DEv-vUltra/Mobile-controller-/Design reference/TPS56A37/Screenshot 2026-10-19 120438.png

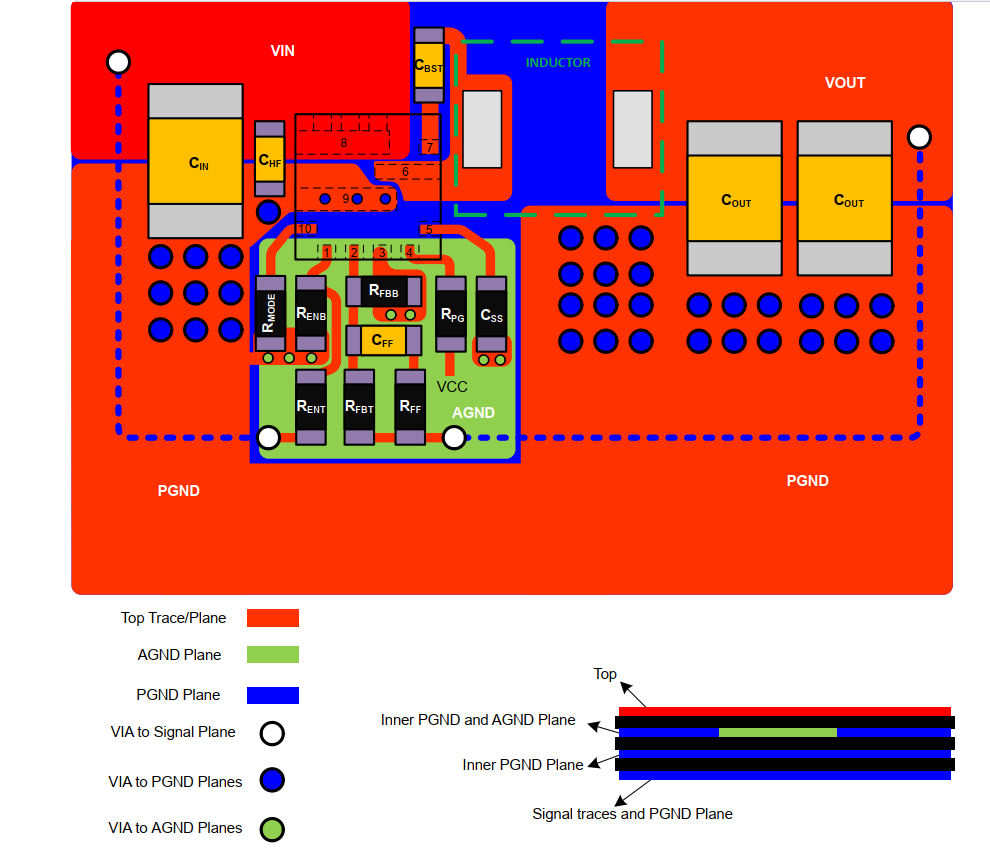
Design reference/TPS56A37/Screenshot 2026-10-19 120438.png
