DEv-vUltra/Mobile-controller-/Manufacture folders/BOM/Mobile_controller_BOM.csv

Id | Designator | Footprint | Quantity | Designation | Manufacturer | Manufacturer Part Number | LCSC Part#
1 | C1, C2, C4, C5, C9, C12, C33, C37, C38, C45, C48, C50, C58 | C_0603_1608Metric_Pad1.08x0.95mm_HandSolder | 13 | 105 | Kyocera AVX | 0603YC105JAT2A | C2177011
2 | C3, C6, C10, C13, C29, C30, C34, C35, C36, C39, C42, C46, C47, C51, C52, C53, C54, C55, C56, C59, C63, C64, C65, Cboot1 | C_0603_1608Metric_Pad1.08x0.95mm_HandSolder | 24 | 104 | Taiyo Yuden | EMK107B7104KA-T | C3868378
3 | C31, C32 | CP_Elec_6.3x5.4 | 2 | 47uF | FOSAN | FVH035ADA470M0654 | C7469958
4 | C40, C41 | C_0805_2012Metric_Pad1.18x1.45mm_HandSolder | 2 | 35pF | YAGEO | CC0805JRNPO9BN330 | C107115
5 | C43, C44 | C_0603_1608Metric_Pad1.08x0.95mm_HandSolder | 2 | 2.2uF | Samsung Electro-Mechanics | CL10A225KO8NNNC | C23630
6 | C49 | C_0603_1608Metric_Pad1.08x0.95mm_HandSolder | 1 | 4.7uF | muRata | GRM188Z71C475KE21D | C389010
7 | C60 | C_0603_1608Metric_Pad1.08x0.95mm_HandSolder | 1 | 47nF | YAGEO | CC0603JRX7R7BB473 | C519536
8 | C61, C62 | C_0603_1608Metric_Pad1.08x0.95mm_HandSolder | 2 | 100pF | YAGEO | CC0603FRNPO9BN101 | C513648
9 | Cboot2 | C_0603_1608Metric_Pad1.08x0.95mm_HandSolder | 1 | 0.01uF | YAGEO | CC0603KRX7R9BB103 | C100042
10 | Cb_inpflt1 | CP_Elec_10x10 | 1 | 33uF | Panasonic | EEHZA1K330P | C128469
11 | Cff1 | C_0603_1608Metric_Pad1.08x0.95mm_HandSolder | 1 | 30pF | FH (Guangdong Fenghua Advanced Tech) | 0603CG300F500NT | C501847
12 | Cf_inpflt1, Cf_inpflt2 | CP_Elec_6.3x5.9 | 2 | 22uF | Panasonic | 35SVPF22M | C88142
13 | Cin1, Cin2 | C_1210_3225Metric_Pad1.33x2.70mm_HandSolder | 2 | 10uF | Taiyo Yuden | MSASU32MSB5106KPNA01 | C5677734
14 | Cin3, Cin4 | C_0805_2012Metric_Pad1.18x1.45mm_HandSolder | 2 | 4.7uF | MuRata | GRM31CR71H475KA12L | C77096
15 | Cinx1 | C_0805_2012Metric_Pad1.18x1.45mm_HandSolder | 1 | 104 | Yageo | CC0805KRX7R9BB104 | C49678
16 | Cout1 | C_1210_3225Metric_Pad1.33x2.70mm_HandSolder | 1 | 22uF | Murata Electronics | GRM32ER61E226KE15L | C65428
17 | Cout3 | CP_EIA-7343-30_AVX-N_HandSolder | 1 | 330uF | Panasonic | 6TPE330MIL | C134173
18 | Css1 | C_0402_1005Metric_Pad0.74x0.62mm_HandSolder | 1 | 104 | MuRata | GRM155R71C223KA01D | C77010
19 | D1 | D_SOD-123 | 1 | 1N4148W | ST(Semtech) | 1N4148W | C81598
20 | D2, D5 | D_SMA | 2 | SS14 SMA | HUXN | SS14(SMA) | C49861244
21 | D3 | LED_0603_1608Metric_Pad1.05x0.95mm_HandSolder | 1 | LED | TONYU | DY-S160806SUWD-100K-T5-4T-03 | C6276853
22 | D4 | DIOM7959X250N | 1 | B540C-13-F | Diodes Inc. | B540C-13-F | C72264
23 | D15 | SOT-23 | 1 | NUP2105L | onsemi | NUP2105LT1G | C14486
24 | F1 | FUSC2012X55N | 1 | MFU0805FF01250P100 | VISHAY | MFU0805FF01250P100 | C1972492
25 | F2 | 01000066Z | 1 | 01000066Z | Littelfuse | 01000066Z | C3204057
26 | FB1 | L_0805_2012Metric_Pad1.05x1.20mm_HandSolder | 1 | CBG201209U601T | FH | CBG201209U601T | C124100
27 | FB2 | L_0805_2012Metric_Pad1.05x1.20mm_HandSolder | 1 | CBW201209U101T | FH | CBW201209U101T | C74487
28 | IC2 | TPS56A37RPAR | 1 | TPS56A37RPAR | TI | TPS56A37RPAR | C22392669
29 | J1 | AMASS_XT60-M_1x02_P7.20mm_Vertical | 1 | Power | Changzhou Amass Elec | XT60-M. | C98733
30 | J2 | JST_PH_S6B-PH-SM4-TB_1x06-1MP_P2.00mm_Horizontal | 1 | MOTOR_LEFT | JST | S6B-PH-SM4-TB(LF)(SN) | C265405
31 | J3 | JST_PH_S6B-PH-SM4-TB_1x06-1MP_P2.00mm_Horizontal | 1 | MOTOR_RIGHT | JST | S6B-PH-SM4-TB(LF)(SN) | C265405
32 | J4 | JST_PH_S4B-PH-SM4-TB_1x04-1MP_P2.00mm_Horizontal | 1 | SW Debug | JST | S4B-PH-SM4-TB(LF)(SN) | C265102
33 | J5 | JST_PH_S4B-PH-SM4-TB_1x04-1MP_P2.00mm_Horizontal | 1 | Telemetry 1 | JST | S4B-PH-SM4-TB(LF)(SN) | C265102
34 | J6 | USB_C_Receptacle_GCT_USB4110 | 1 | USB_C_2.0 | Global Connector Technology | USB4110-GF-A | C5143397
35 | J7 | JST_PH_S3B-PH-SM4-TB_1x03-1MP_P2.00mm_Horizontal | 1 | CAN BUS | JST | S3B-PH-SM4-TB(LF)(SN) | C265101
36 | J8 | PinHeader_1x03_P2.54mm_Vertical | 1 | BOOT_MODE | BOOMELE(Boom Precision Elec) | 2.54-1*3P | C49257
37 | J9 | JST_PH_S4B-PH-SM4-TB_1x04-1MP_P2.00mm_Horizontal | 1 | RC Control | JST | S4B-PH-SM4-TB(LF)(SN) | C265102
38 | J10 | PinHeader_1x03_P2.54mm_Horizontal | 1 | RC Servo | BOOMELE(Boom Precision Elec) | 2.54-1*3P | C92159
39 | L1 | L_12x12mm_H8mm | 1 | 22uH_6.3A | Vishay-Dale | IHLP4040DZER220M11 | C845072
40 | L2 | SRN80408R2Y | 1 | SRN8040-2R2Y | Coilcraft | XAL6060-562MEB | C7419740
41 | L4 | L_Coilcraft_XAL6060-XXX | 1 | 5.6uH | Bourns | SRN8040-2R2Y | C711710
42 | R1, R13, R14, R15, R17 | R_0603_1608Metric_Pad0.98x0.95mm_HandSolder | 5 | 4.7k | YAGEO | RC0603FR-074K7L | C99782
43 | R2 | R_1206_3216Metric_Pad1.30x1.75mm_HandSolder | 1 | 562 | RALEC | RTT065620FTP | C246596
44 | R10, R11 | R_1206_3216Metric_Pad1.30x1.75mm_HandSolder | 2 | 0.2 | PANASONIC | ERJ8CWFR020V | C713435
45 | R12, R16, R18, R19, R22, Rfbt2 | R_0603_1608Metric_Pad0.98x0.95mm_HandSolder | 6 | 10k | UNI-ROYAL(Uniroyal Elec) | 0603WAF1002T5E | C25804
46 | R20, R21 | R_0805_2012Metric_Pad1.20x1.40mm_HandSolder | 2 | 5.1k | YAGEO | RT0805FRE075K1L | C869519
47 | R23, R24 | R_0402_1005Metric_Pad0.72x0.64mm_HandSolder | 2 | 62 | UNI-ROYAL(Uniroyal Elec) | 0402WGF620JTCE | C4962
48 | Rd_inpflt1 | R_0603_1608Metric | 1 | 0.1 | Panasonic | ERJ-3RSFR10V | C713431
49 | Rfbb1 | R_0402_1005Metric_Pad0.72x0.64mm_HandSolder | 1 | 20k | Vishay-Dale | CRCW040220K0FKED | C482096
50 | Rfbb2 | R_0603_1608Metric_Pad0.98x0.95mm_HandSolder | 1 | 3.3k | Vishay-Dale | CRCW06033K24FKEA | C844165
51 | Rfbt1 | R_0805_2012Metric_Pad1.20x1.40mm_HandSolder | 1 | 383k | Panasonic | ERJ-6ENF3833V | C3025630
52 | Rmode1 | R_0402_1005Metric_Pad0.72x0.64mm_HandSolder | 1 | 52.3k | Vishay-Dale | CRCW040252K3FKED | C843906
53 | Rpg1 | R_0402_1005Metric_Pad0.72x0.64mm_HandSolder | 1 | 100k | Vishay-Dale | CRCW0402100KFKED | C481918
54 | SW2 | SW_SPST_TS-1088-xR025 | 1 | RESET | XUNPU | TS-1088R-02026 | C455280
55 | U1 | SOT-23-5 | 1 | AP2112K-3.3 | TECH PUBLIC | AP2112K-3.3TRG1 | C23380830
56 | U2 | SOT-223-3_TabPin2 | 1 | AMS1117-3.3 | Advanced Monolithic Systems | AMS1117-3.3 | C6186
57 | U3 | TI_SO-PowerPAD-8_ThermalVias | 1 | TPS5430DDA | TI | TPS5430DDAR | C9864
58 | U4 | SOT-223-3_TabPin2 | 1 | AMS1117-1.8 | JSMSEMI | AMS1117-1.8 | C963404
59 | U6 | VSSOP-8_2.3x2mm_P0.5mm | 1 | TXS0102DCU | TI | TXS0102DCUR | C53434
60 | U7, U8 | Texas_HTSOP-8-1EP_3.9x4.9mm_P1.27mm_EP2.95x4.9mm_Mask2.4x3.1mm_ThermalVias | 2 | DRV8870DDA | TI | DRV8870DDAR | C86590
61 | U9 | Bosch_LGA-8_2x2.5mm_P0.65mm_ClockwisePinNumbering | 1 | BMP280 | Bosch | BMP280 | C83291
62 | U10 | Quectel_L80-R | 1 | L80-R | Quectel | L80RE-M37 | C3029061
63 | U11 | InvenSense_QFN-24_3x3mm_P0.4mm | 1 | ICM-20948 | TDK InvenSense | ICM-20948 | C726001
64 | U12 | LQFP-64_10x10mm_P0.5mm | 1 | STM32F405RGTx | ST | STM32F405RGT7 | C1337199
65 | U13 | SOT-23-6 | 1 | SN74LVC1T45DBV | TI | SN74LVC1T45DBVR | C7843
66 | U14 | SOT-23-6 | 1 | USBLC6-2SC6 | UMW | USBLC6-2SC6 | C2687116
67 | U15 | SOIC-8_3.9x4.9mm_P1.27mm | 1 | SN65HVD230 | TI | SN65HVD230DR | C12084
68 | Y1 | Crystal_SMD_5032-4Pin_5.0x3.2mm | 1 | 8MHz | YXC Crystal Oscillators | X50328MSB4SI | C157341
