DEv-vUltra/Mobile-controller-/Manufacture folders/Schematic and Assembly PDF/Mobile_controller_assembly.pdf

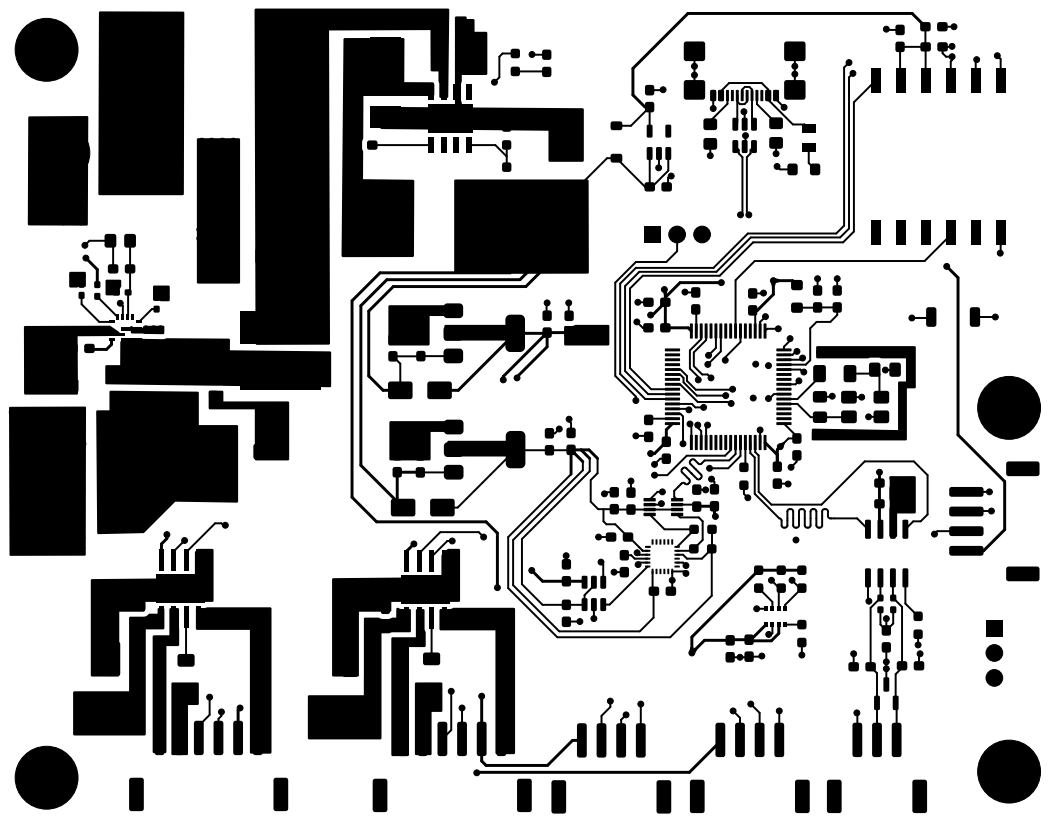
[picture p4: page 1]

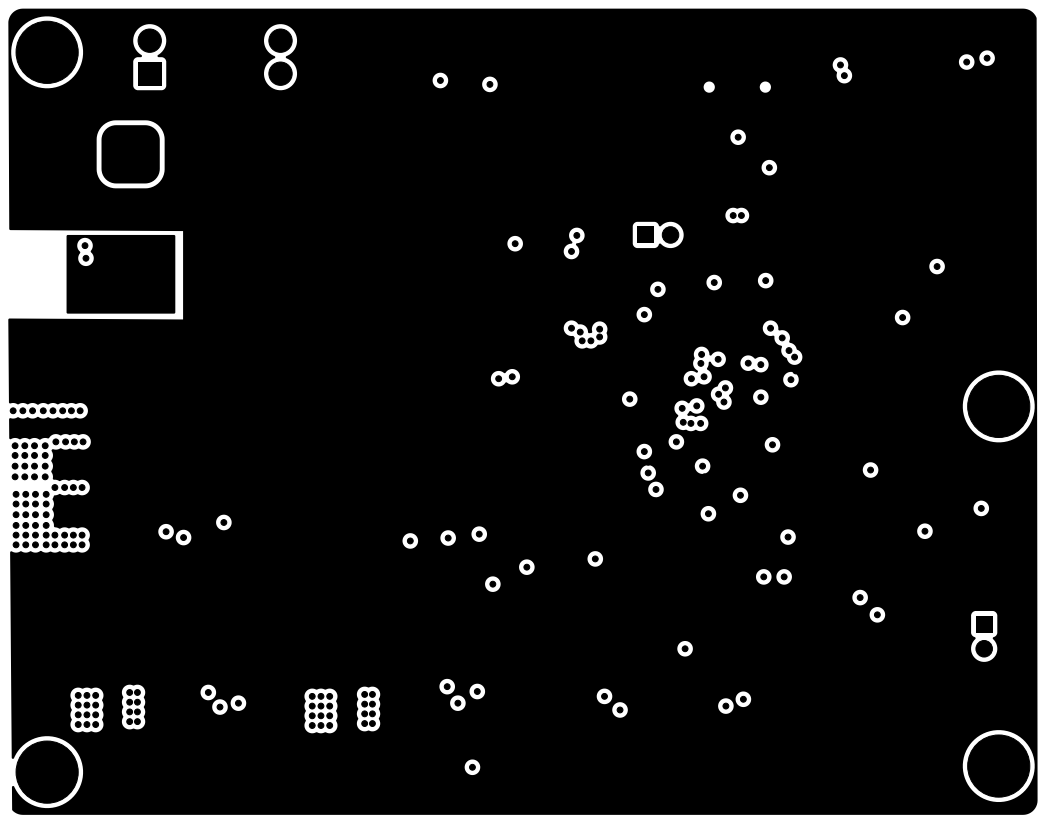
[picture p5: page 2]

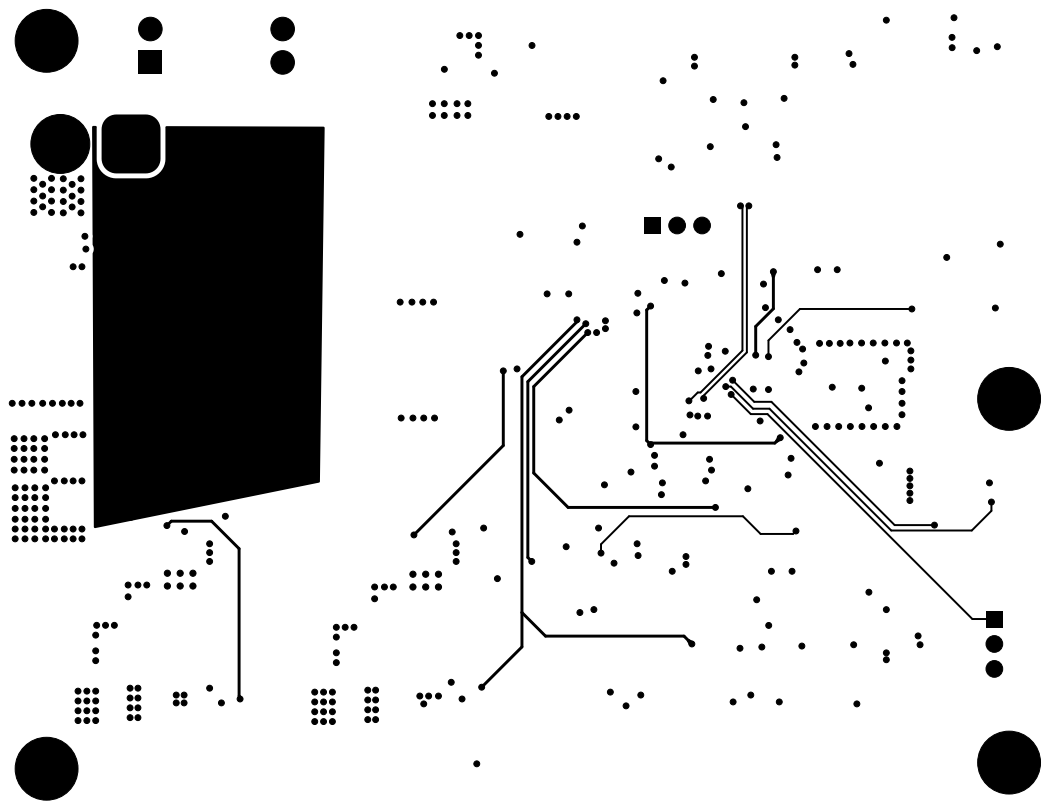
[picture p6: page 3]

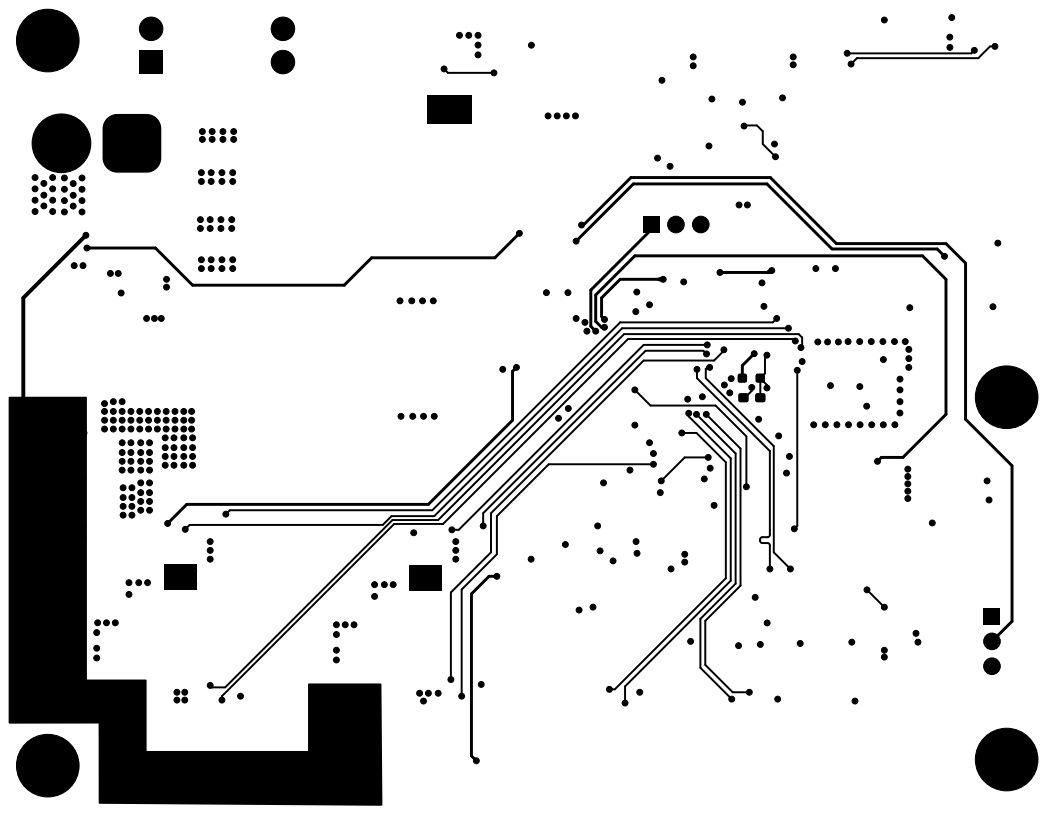
[picture p7: page 4]

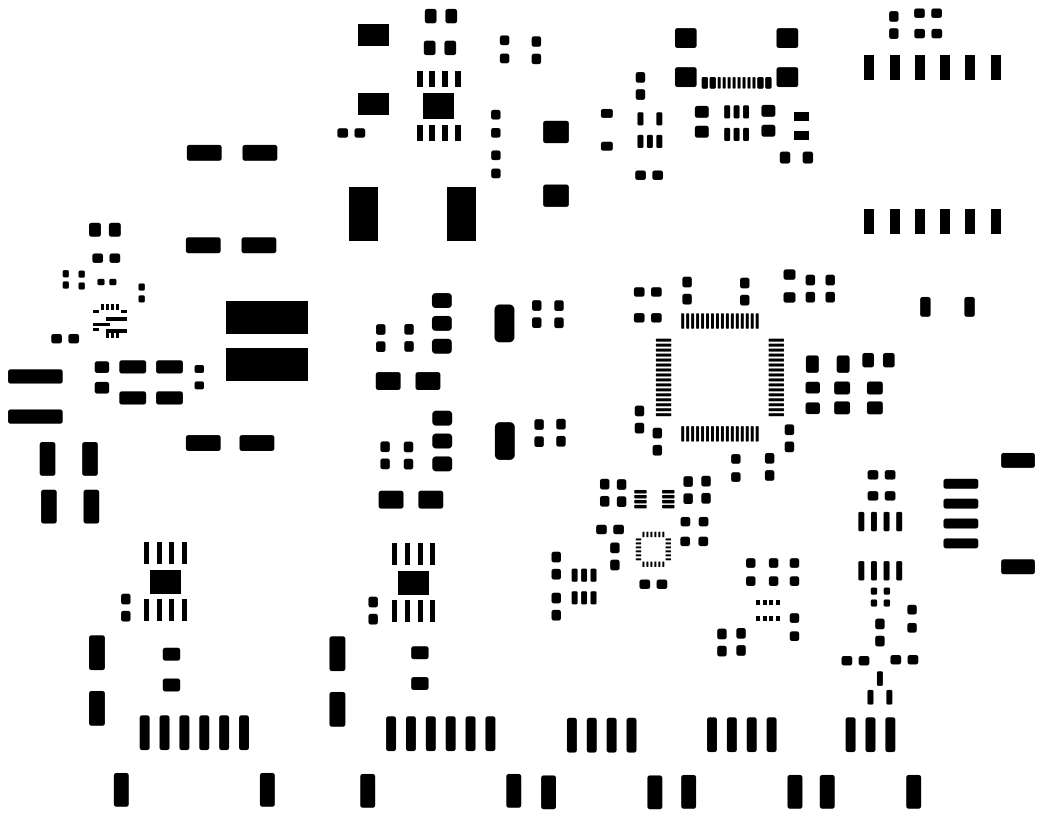
[picture p8: page 5]

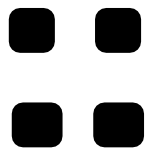
[picture p9: page 6]

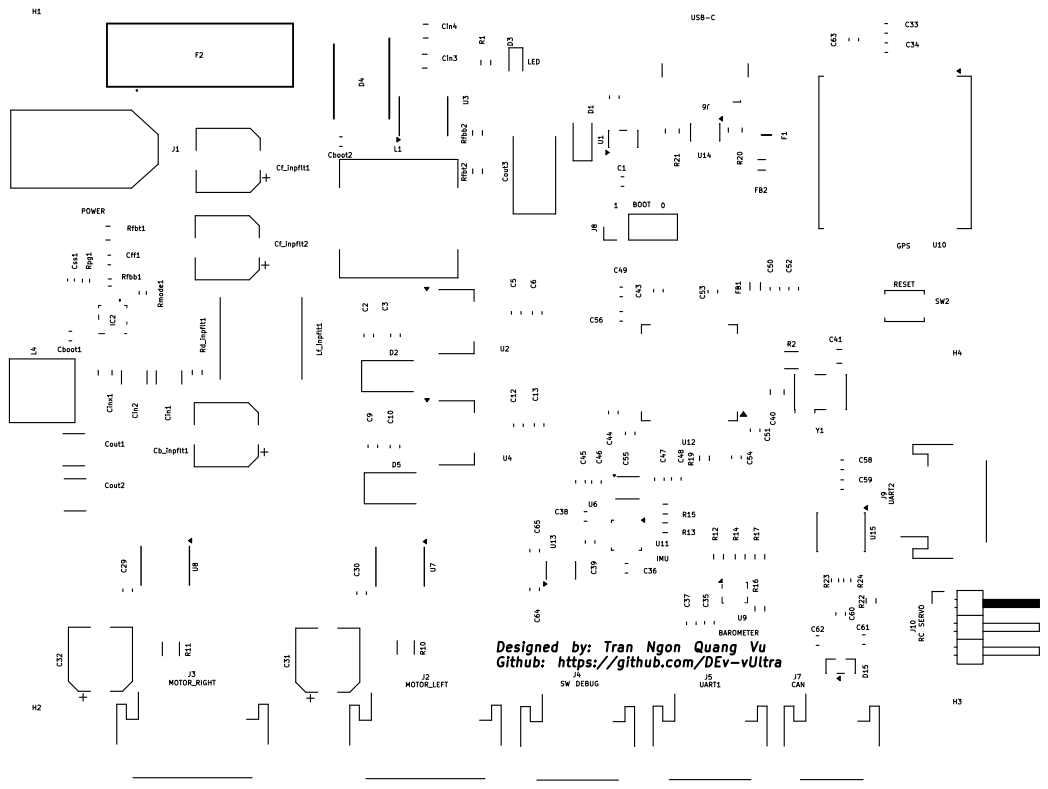
[picture p10: page 7]

LED Designed by: Tran Ngon Quang Vu Github: https://github.com/DEv-vUltra F1 C45

M1 GND ENA ENB 3V3 M2 M1 GND ENA ENB 3V3 M2 3V3 SWD SCLK GND 5V RX TX GND GND CANL CANH GND TX RX 5V PWM 5V GND

C42 R18

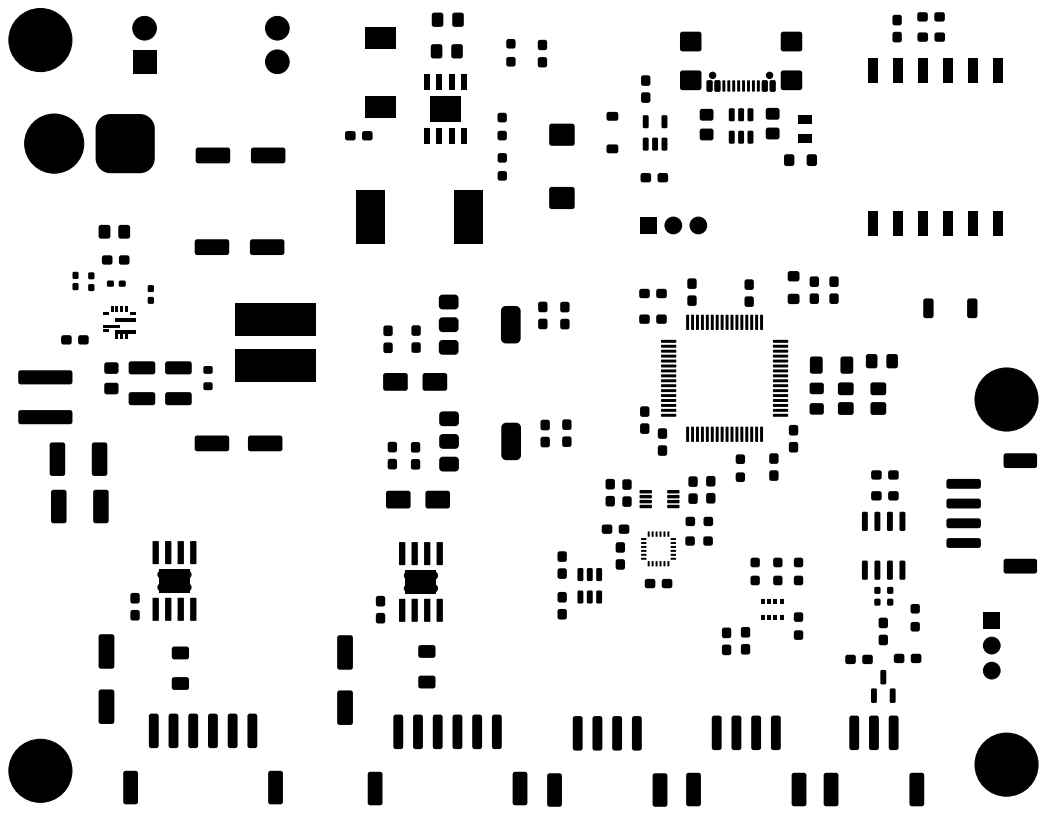
[picture p11: page 9]

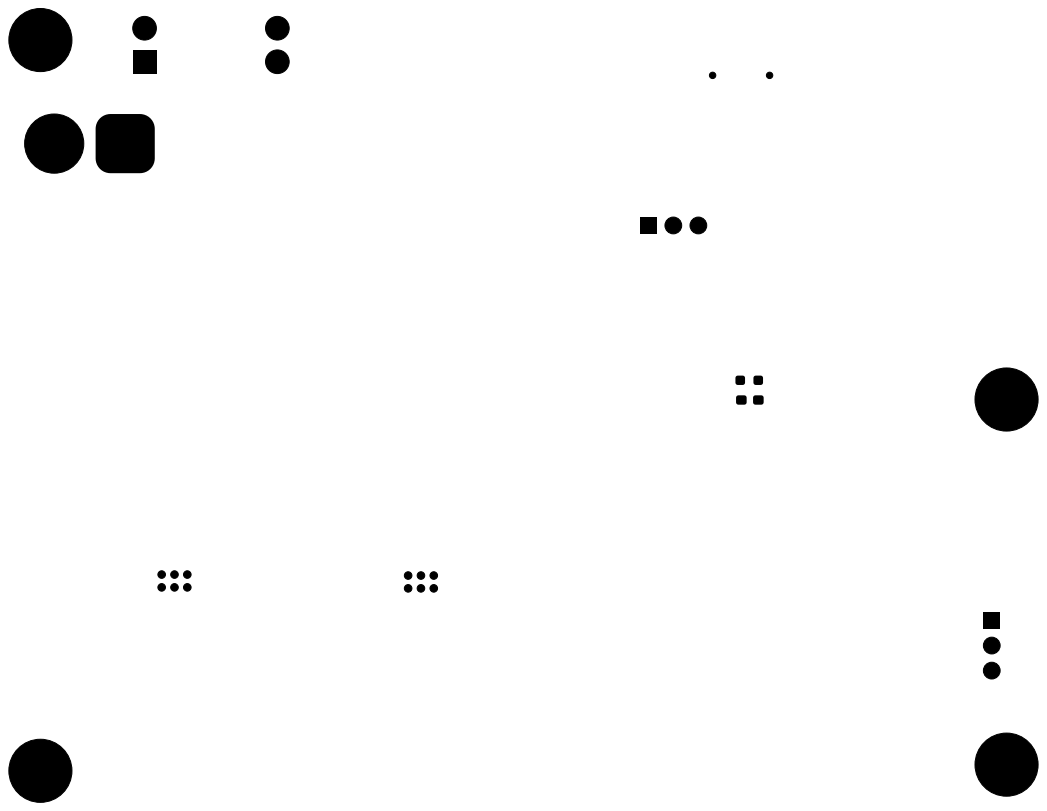
[picture p12: page 10]

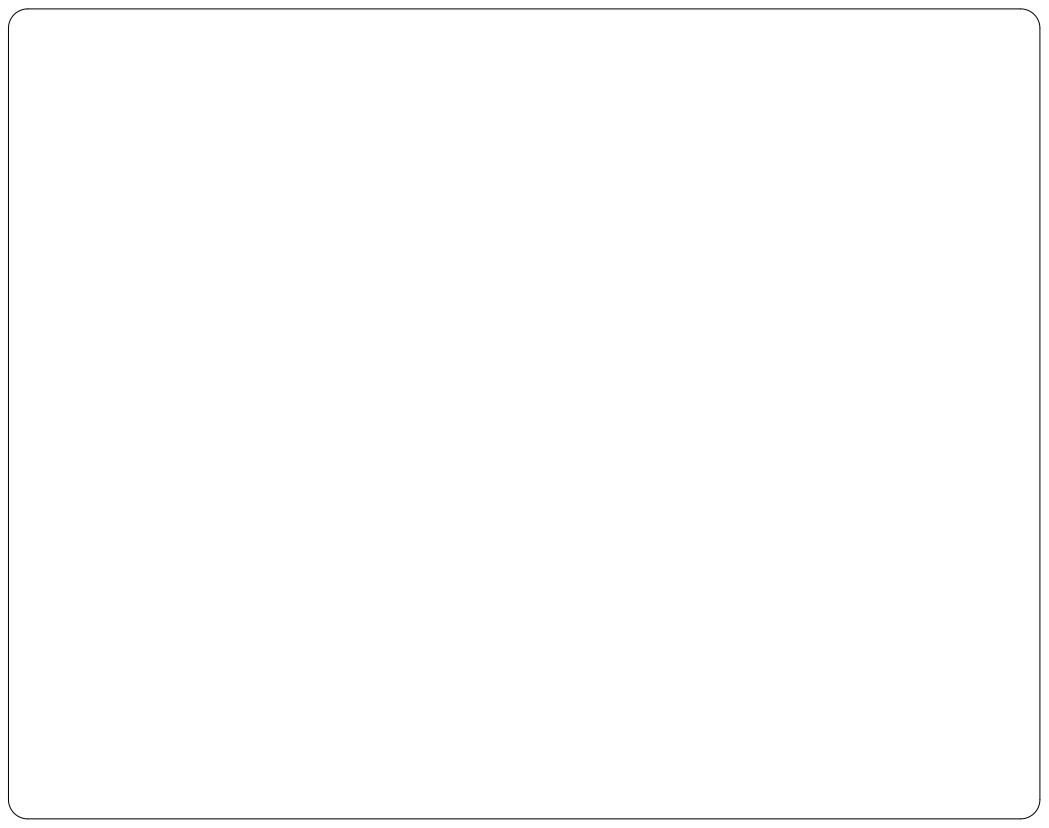
[picture p13: page 11]
