DEv-vUltra/Mobile-controller-/Manufacture folders/Schematic and Assembly PDF/Mobile_controller_assembly_final.pdf

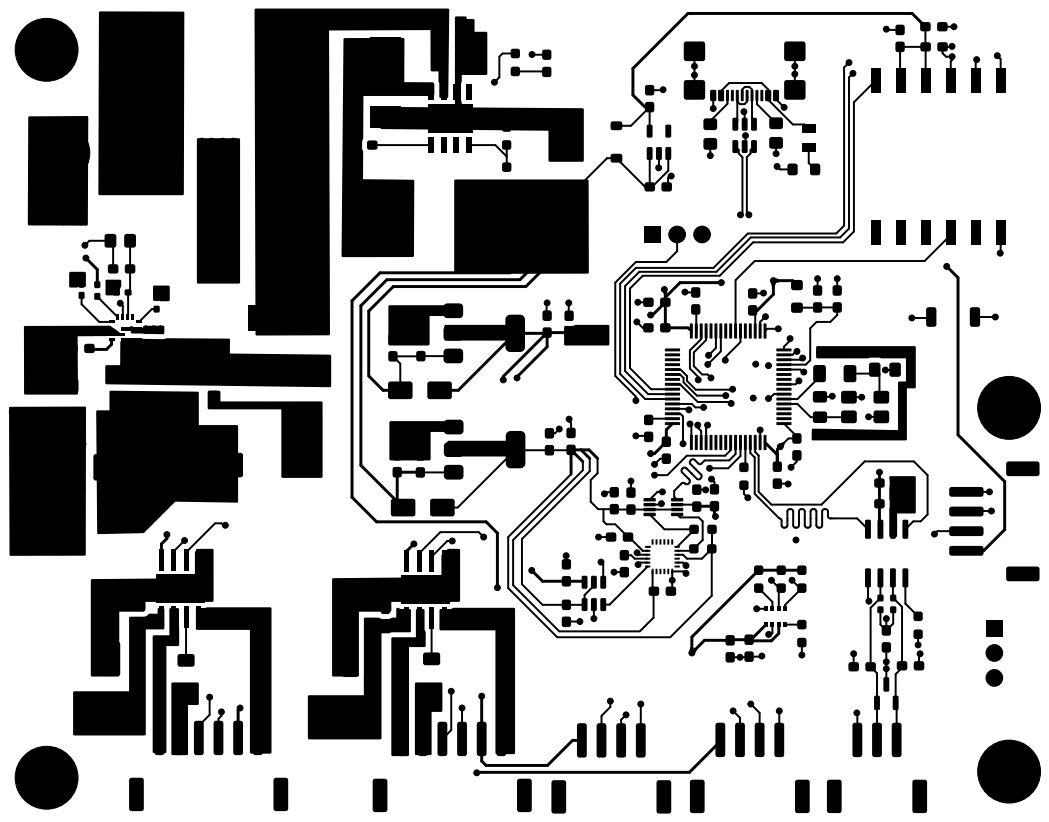
[picture p14: page 1]


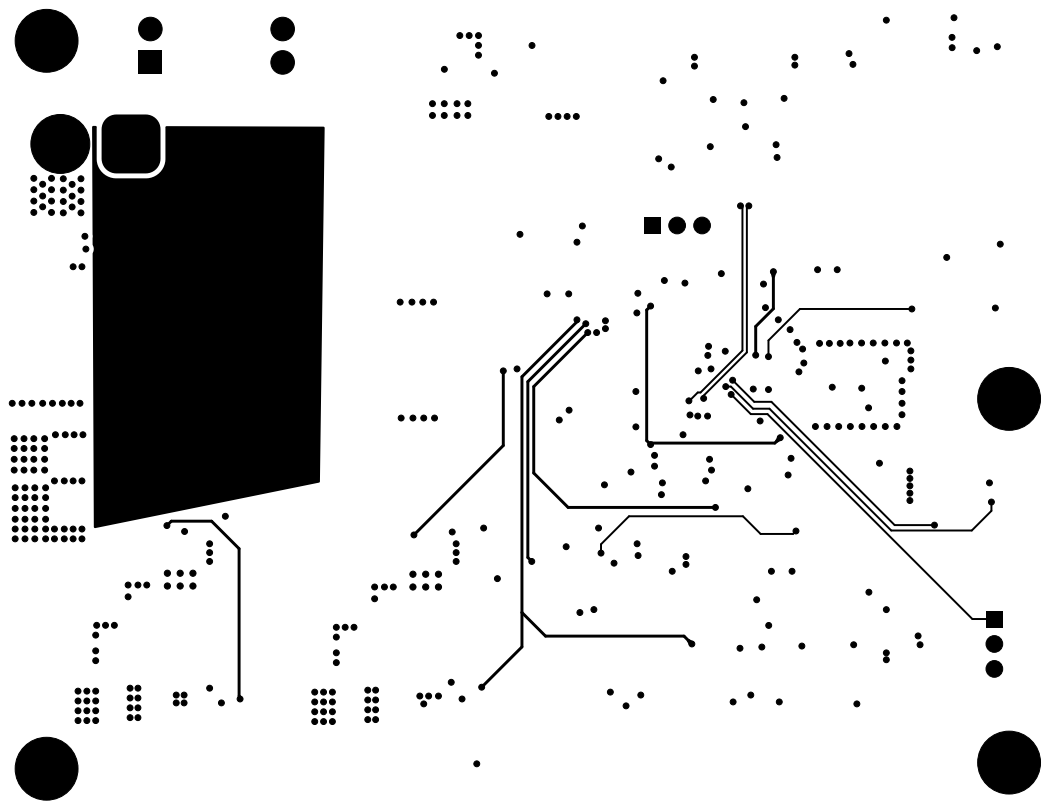
[picture p15: page 3]

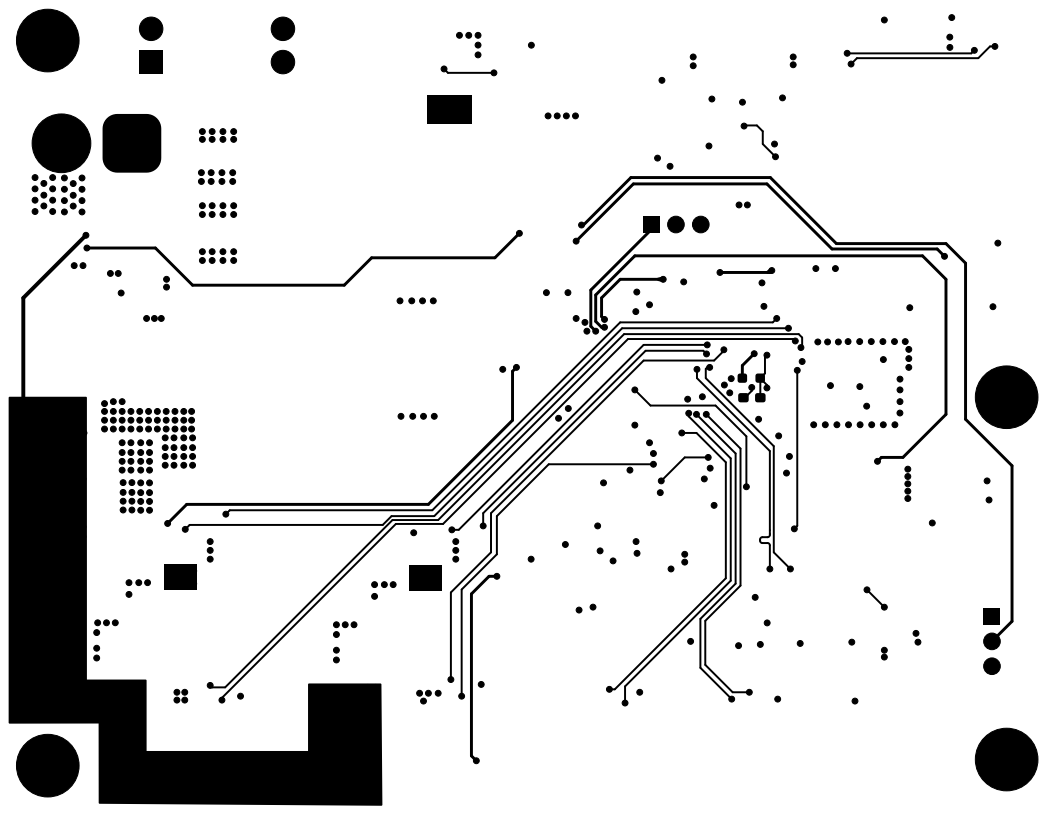
[picture p16: page 4]

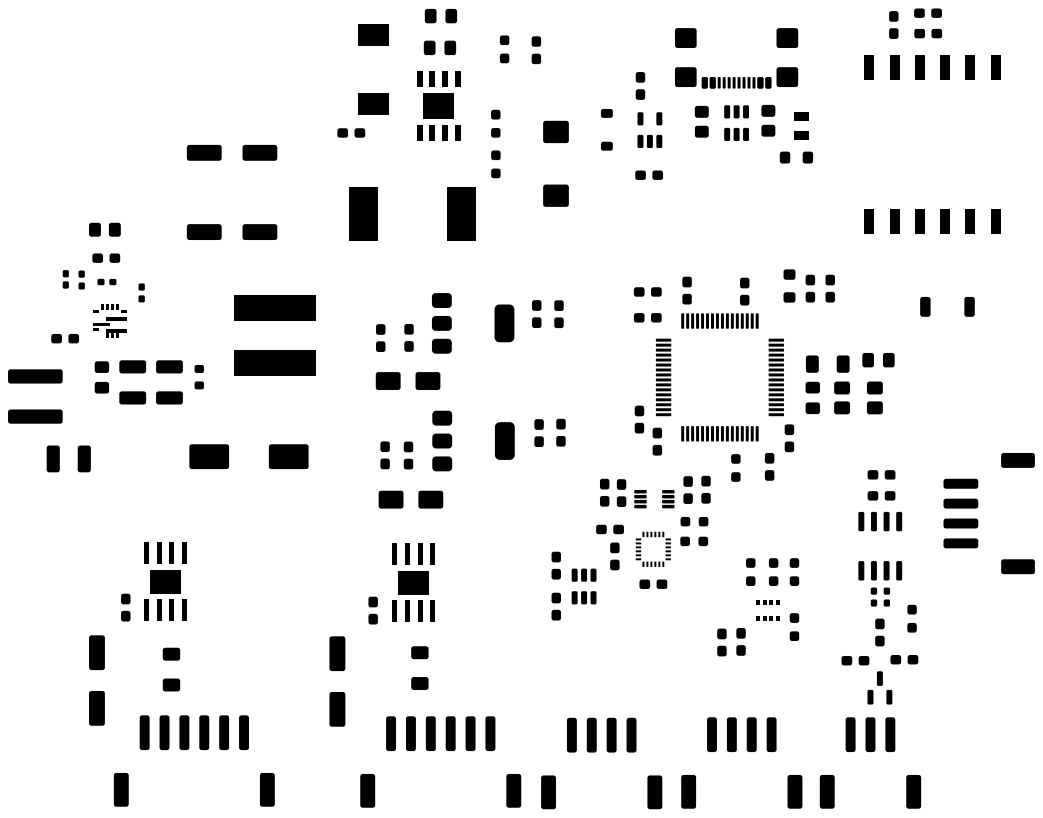
[picture p17: page 5]


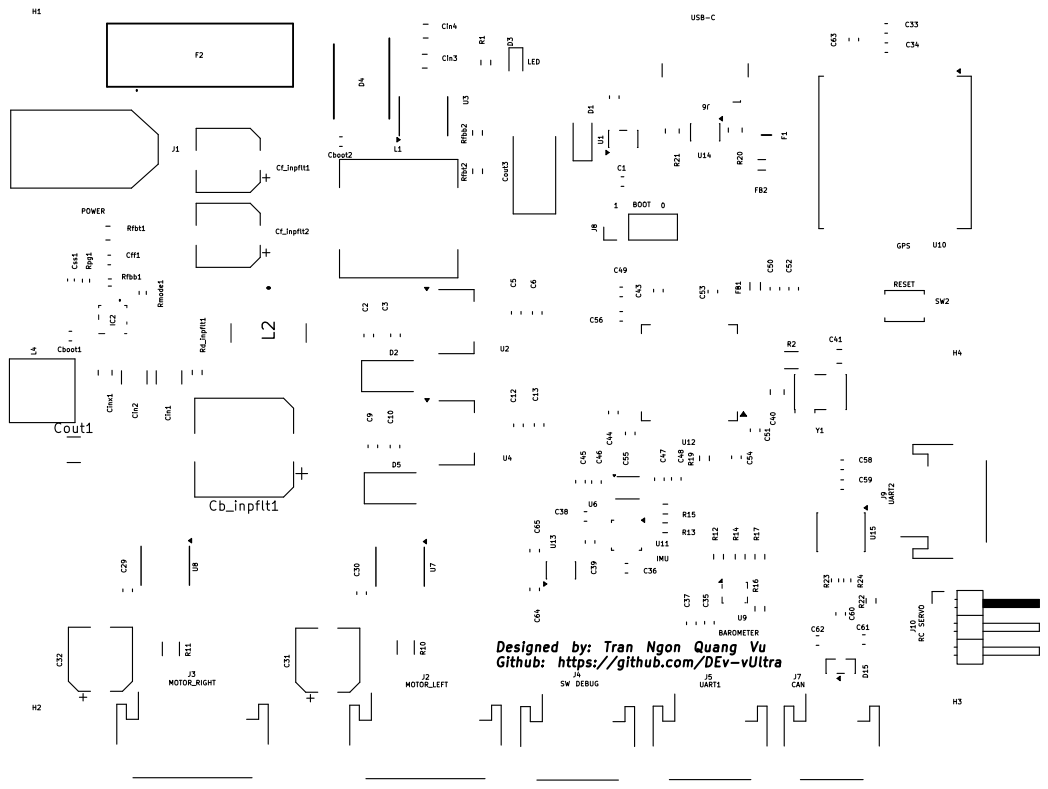
[picture p18: page 7]

LED Designed by: Tran Ngon Quang Vu Github: https://github.com/DEv-vUltra L2 Cf_inpflt2 H1

M1 GND ENA ENB 3V3 M2 M1 GND ENA ENB 3V3 M2 3V3 SWD SCLK GND 5V RX TX GND GND CANL CANH GND TX RX 5V PWM 5V GND

C42 R18

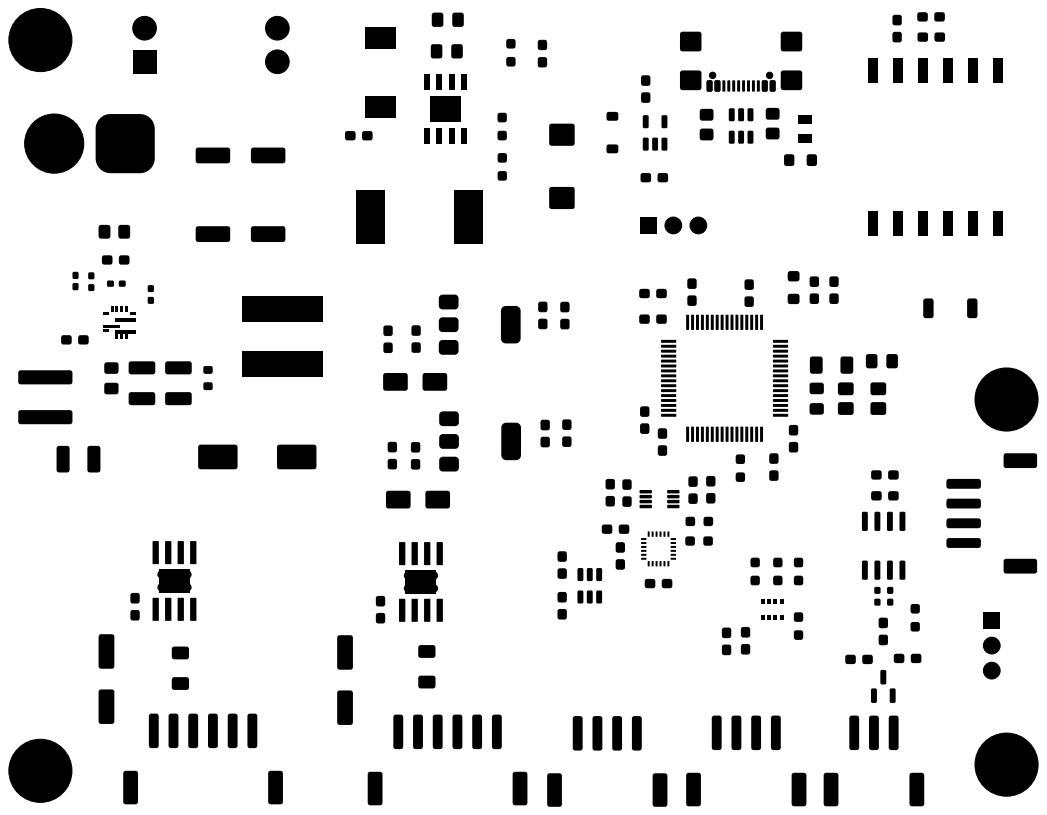
[picture p19: page 9]
