DEv-vUltra/Mobile-controller-/Manufacture folders/Schematic PDF/Mobile_controller_schematic.pdf

Controller File: MCU-Sensors.kicad_sch Driver File: Driver.kicad_sch

This sheet contains 3 different hierarchical sheets

Size: A5 | Rev: | C Date: 2026-08-27
KiCad E.D.A. 10.0.2 | Id: 1/4


**Notice SS34 SMA can be

Diodes are used to protect from reverse polarity and discharge PWR_FLAG

LDO with high efficiency current output (98.5%) -Max current: 0.6A -> easy

to provide current for GPS
(less than 100mA) -Low output noise: 50μVRMS

LDO 3.3V (Except for GPS)

Connector J3 use to connect power source from driver to controller

LDO can provide and withstand 1A current -> very abundant for 250mA

Size: A4 | Rev:
KiCad E.D.A. 10.0.2 | Id: 2/4

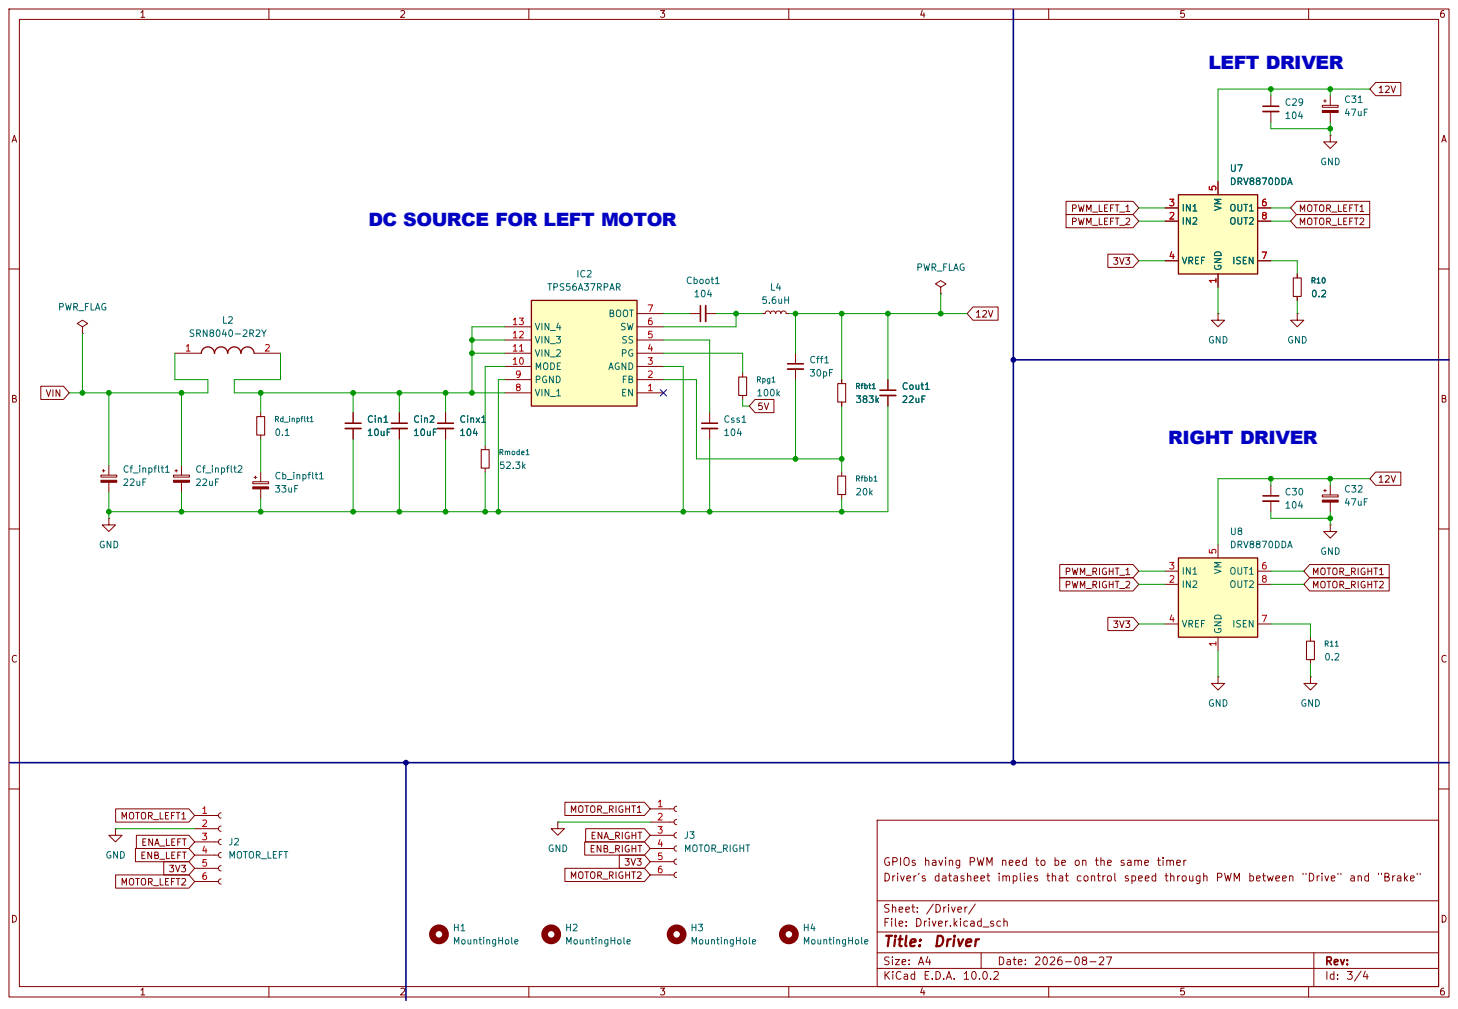
[picture p24: page 3]

Driver's datasheet implies that control speed through PWM between "Drive" and "Brake"

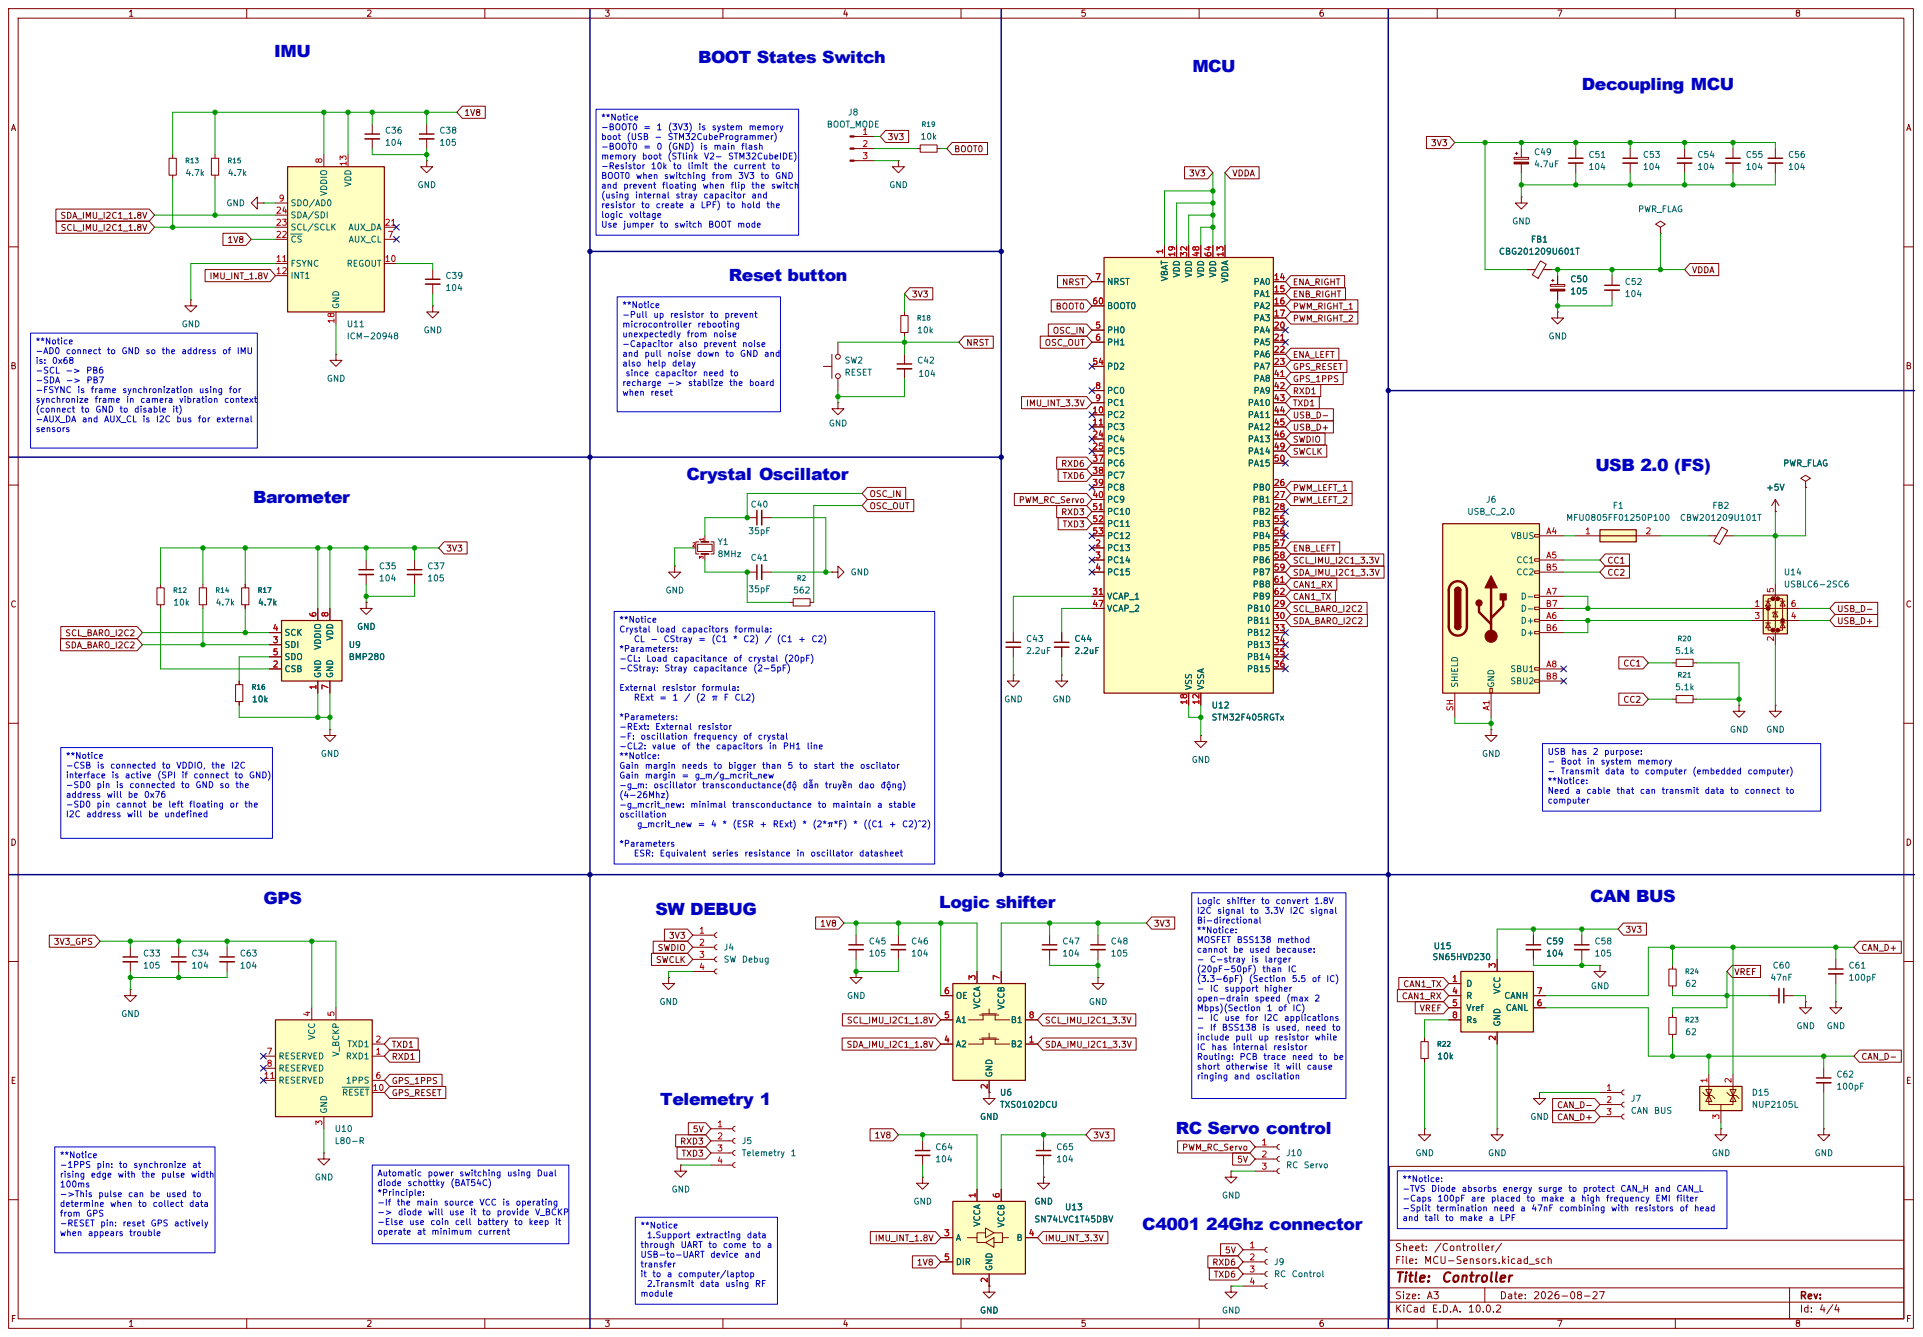
[picture p25: page 4]

recharge -> stablize the board when reset **Notice -BOOT0 = 1 (3V3) is system memory boot (USB - STM32CubeProgrammer) -BOOT0 = 0 (GND) is main flash memory boot (STlink V2- STM32CubeIDE) -Resistor 10k to limit the current to BOOT0 when switching from 3V3 to GND

and prevent floating when flip the switch
(using internal stray capacitor and
resistor to create a LPF) to hold the

g_mcrit_new = 4 * (ESR + RExt) * (2*π*F) * ((C1 + C2)^2) *Parameters ESR: Equivalent series resistance in oscillator datasheet Reset button

**Notice -Pull up resistor to prevent microcontroller rebooting

unexpectedly from noise -Capacitor also prevent noise and pull noise down to GND and

**Notice -AD0 connect to GND so the address of IMU

is: 0x68 -SCL -> PB6 -SDA -> PB7 -FSYNC is frame synchronization using for synchronize frame in camera vibration context (connect to GND to disable it) -AUX_DA and AUX_CL is I2C bus for external sensors

also help delay since capacitor need to

**Notice Crystal load capacitors formula: CL - CStray = (C1 * C2) / (C1 + C2) *Parameters: -CL: Load capacitance of crystal (20pF)

-CStray: Stray capacitance (2-5pF) External resistor formula: RExt = 1 / (2 π F CL2) *Parameters: -RExt: External resistor -F: oscillation frequency of crystal -CL2: value of the capacitors in PH1 line

**Notice -CSB is connected to VDDIO, the I2C

**Notice: Gain margin needs to bigger than 5 to start the oscilator Gain margin = g_m/g_mcrit_new -g_m: oscillator transconductance(độ dẫn truyền dao động)

interface is active (SPI if connect to GND) -SD0 pin is connected to GND so the address will be 0x76 -SD0 pin cannot be left floating or the

(4-26Mhz)
-g_mcrit_new: minimal transconductance to maintain a stable oscillation

I2C address will be undefined

Logic shifter to convert 1.8V
I2C signal to 3.3V I2C signal Bi-directional **Notice: MOSFET BSS138 method

cannot be used because: - C-stray is larger

(20pF-50pF) than IC
(3.3-6pF) (Section 5.5 of IC) - IC support higher

open-drain speed (max 2 Mbps)(Section 1 of IC) - IC use for I2C applications - If BSS138 is used, need to

include pull up resistor while
IC has internal resistor Routing: PCB trace need to be

short otherwise it will cause
ringing and oscilation
RC Servo control

*Principle: -If the main source VCC is operating -> diode will use it to provide V_BCKP -Else use coin cell battery to keep it operate at minimum current **Notice -1PPS pin: to synchronize at rising edge with the pulse width 100ms ->This pulse can be used to

Automatic power switching using Dual diode schottky (BAT54C)

**Notice: -TVS Diode absorbs energy surge to protect CAN_H and CAN_L -Caps 100pF are placed to make a high frequency EMI filter -Split termination need a 47nF combining with resistors of head

determine when to collect data
from GPS -RESET pin: reset GPS actively when appears trouble

and tail to make a LPF

**Notice 1.Support extracting data

through UART to come to a USB-to-UART device and

transfer
it to a computer/laptop 2.Transmit data using RF module
