DEv-vUltra/Mobile-controller-/(commit log)

2026-10-27 Rename CPL_4 - Sheet1.csv to CPL.csv
    [CPL.csv]
2026-10-27 Add Mobile_controller_BOM.csv file
    [Mobile_controller_BOM.csv]
2026-10-27 Revise README for mobile controller details
    Expanded the README to provide detailed information about the mobile controller's features, power architecture, interfaces, design notes, and getting started instructions.
